jre/sassuino/sassuino-uno-dip/sassuino-uno-dip.kicad_pcb

## KiCad design sassuino-uno-dip/sassuino-uno-dip.kicad_pcb (2025-06-15)

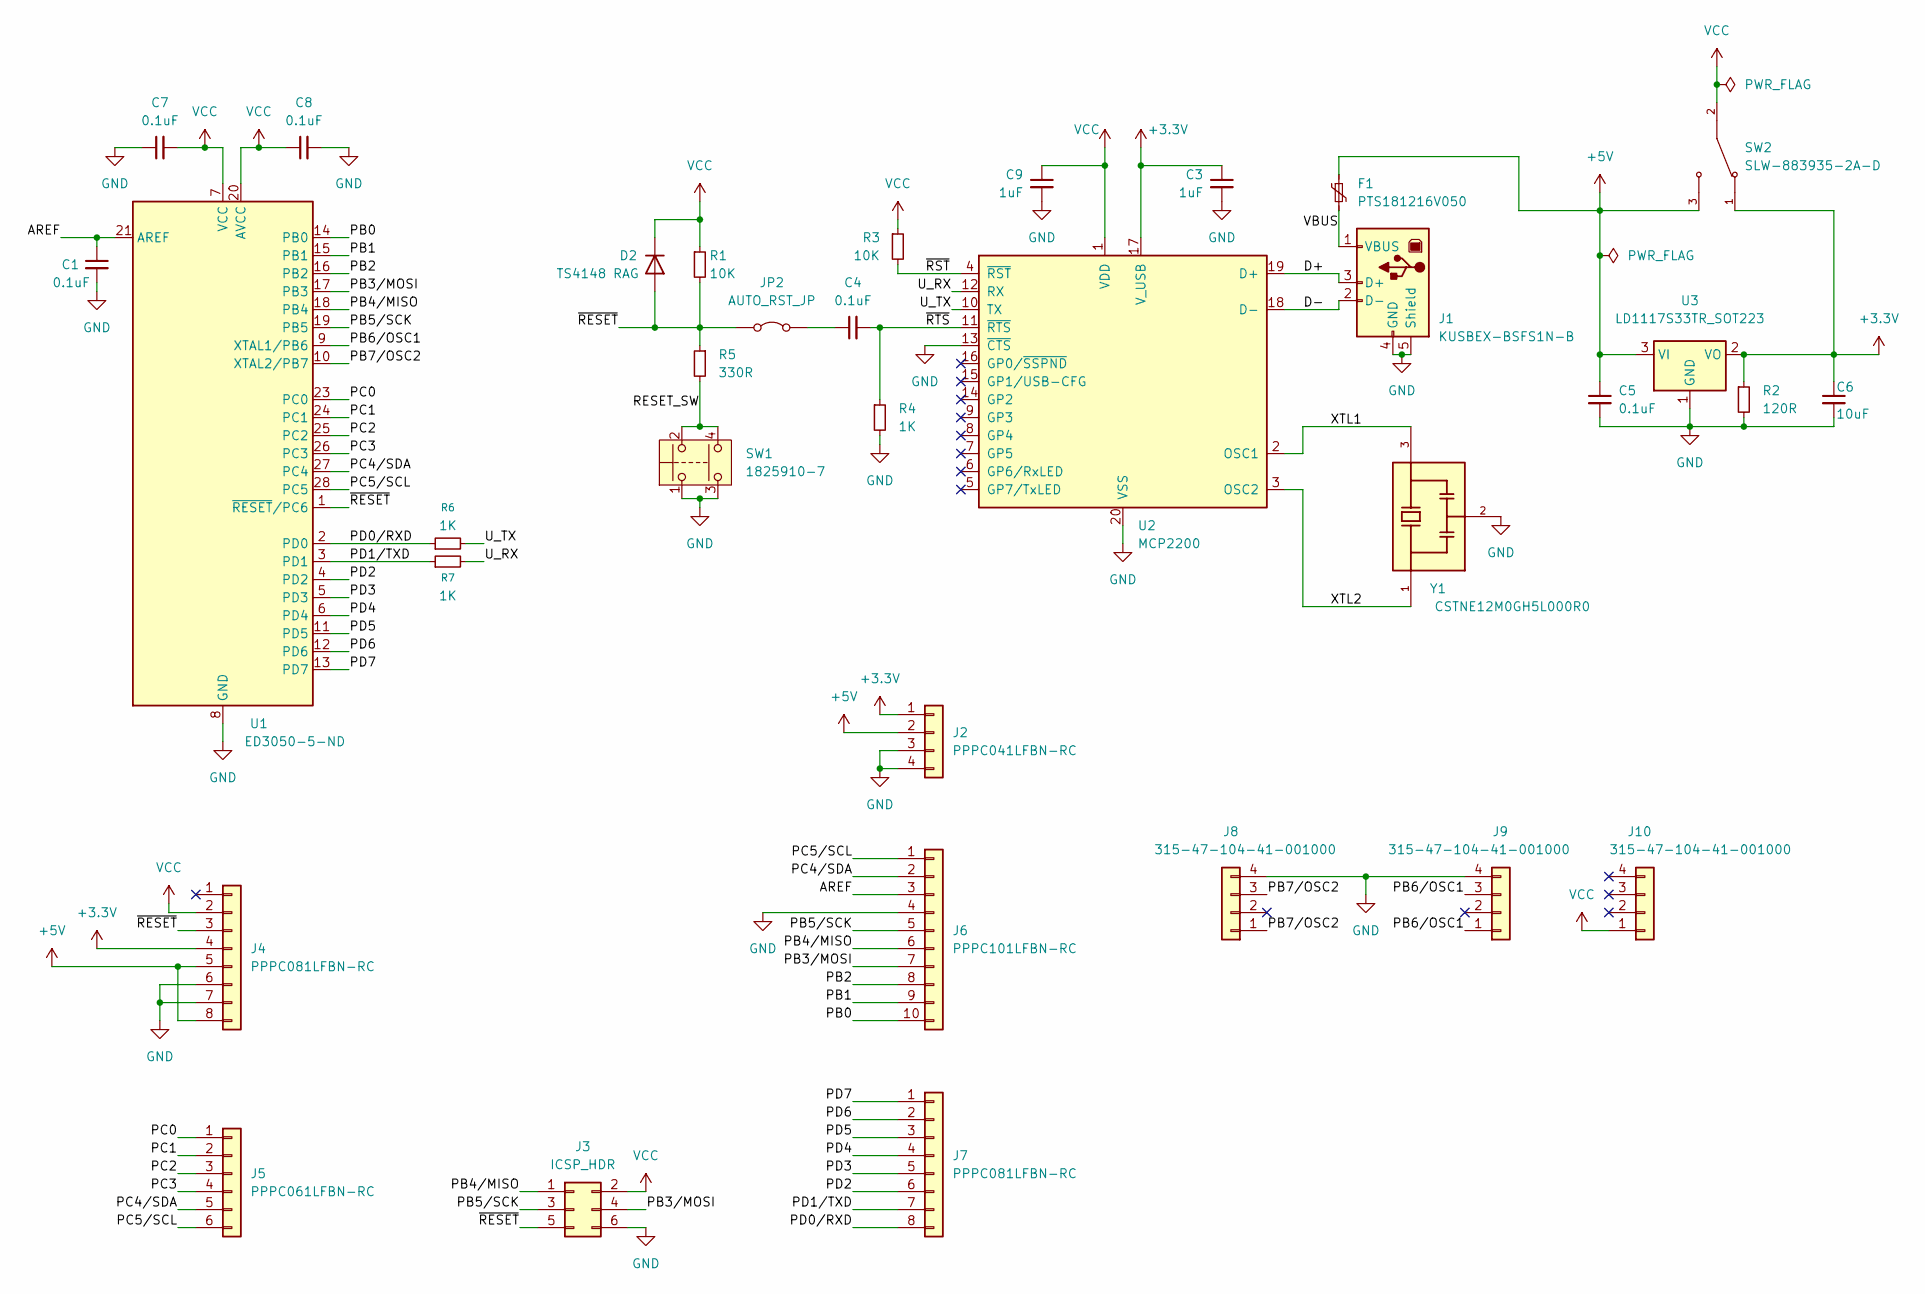
[picture p1: schematic sassuino-uno-dip.kicad_sch, Sassuino Uno DIP]

Parts:
C1, C4, C5, C7, C8: 0.1uF; C_1206_3216Metric
C3, C9: 1uF; C_1206_3216Metric
C6: 10uF; C_1206_3216Metric
D2: TS4148 RAG; D_1206_3216Metric
F1: PTS181216V050; Fuse_1812_4532Metric
J1: KUSBEX-BSFS1N-B; USB_B_Lumberg_2411_02_Horizontal
J2: PPPC041LFBN-RC; PinSocket_1x04_P2.54mm_Vertical
J3: ICSP_HDR; PinHeader_2x03_P2.54mm_Vertical
J4, J7: PPPC081LFBN-RC; PinSocket_1x08_P2.54mm_Vertical
J5: PPPC061LFBN-RC; PinSocket_1x06_P2.54mm_Vertical
J6: PPPC101LFBN-RC; PinSocket_1x10_P2.54mm_Vertical
J8, J9, J10: 315-47-104-41-001000; PinSocket_1x04_P2.54mm_Vertical_LowProfile
JP2: AUTO_RST_JP; PinHeader_1x02_P2.54mm_Vertical
R1, R3: 10K; R_1206_3216Metric
R2: 120R; R_1206_3216Metric
R4, R6, R7: 1K; R_1206_3216Metric
R5: 330R; R_1206_3216Metric
SW1: 1825910-7; SW4_1825910-B_TEC
SW2: SLW-883935-2A-D; SW_SLW-883935-2A-D; PARTREV 1.01
U1: ED3050-5-ND; DIP-28_W7.62mm_Socket_LongPads
U2: MCP2200; SOIC-20W_7.5x12.8mm_P1.27mm
U3: LD1117S33TR_SOT223; SOT-223-3_TabPin2
Y1: CSTNE12M0GH5L000R0; OSC_CSTNE12M0GH5L000R0; PARTREV JGC42-8858A

Connections:
+3.3V: C3.1, C6.1, J2.1, J4.4, R2.1, SW2.1, U2.17 (V_USB), U3.2 (VO)
+5V: C5.1, F1.1, J2.2, J4.5, J4.8, SW2.3, U3.3 (VI)
/AREF: C1.1, J6.3, U1.21 (AREF)
/D+: J1.3 (D+), U2.19 (D+)
/D-: J1.2 (D-), U2.18 (D-)
/PB0: J6.10, U1.14 (PB0)
/PB1: J6.9, U1.15 (PB1)
/PB2: J6.8, U1.16 (PB2)
/PB3/MOSI: J3.4, J6.7, U1.17 (PB3)
/PB4/MISO: J3.1, J6.6, U1.18 (PB4)
/PB5/SCK: J3.3, J6.5, U1.19 (PB5)
/PB6/OSC1: J9.1, J9.3, U1.9 (XTAL1/PB6)
/PB7/OSC2: J8.1, J8.3, U1.10 (XTAL2/PB7)
/PC0: J5.1, U1.23 (PC0)
/PC1: J5.2, U1.24 (PC1)
/PC2: J5.3, U1.25 (PC2)
/PC3: J5.4, U1.26 (PC3)
/PC4/SDA: J5.5, J6.2, U1.27 (PC4)
/PC5/SCL: J5.6, J6.1, U1.28 (PC5)
/PD0/RXD: J7.8, R6.1, U1.2 (PD0)
/PD1/TXD: J7.7, R7.1, U1.3 (PD1)
/PD2: J7.6, U1.4 (PD2)
/PD3: J7.5, U1.5 (PD3)
/PD4: J7.4, U1.6 (PD4)
/PD5: J7.3, U1.11 (PD5)
/PD6: J7.2, U1.12 (PD6)
/PD7: J7.1, U1.13 (PD7)
/RESET_SW: R5.2, SW1.2, SW1.4
/U_RX: R7.2, U2.12 (RX)
/U_TX: R6.2, U2.10 (TX)
/VBUS: F1.2, J1.1 (VBUS)
/XTL1: U2.2 (OSC1), Y1.3
/XTL2: U2.3 (OSC2), Y1.1
/~RESET: D2.2 (A), J3.5, J4.3, JP2.1 (A), R1.2, R5.1, U1.1 (~RESET/PC6)
/~RST: R3.2, U2.4 (~RST)
/~RTS: C4.2, R4.1, U2.11 (~RTS)
GND: C1.2, C3.2, C5.2, C6.2, C7.1, C8.2, C9.2, J1.4 (GND), J1.5 (Shield), J2.3, J2.4, J3.6, J4.6, J4.7, J6.4, J8.4, J9.4, R2.2, R4.2, SW1.1, SW1.3, U1.8 (GND), U1.22 (GND), U2.13 (~CTS), U2.20 (VSS), U3.1 (GND), Y1.2
unnamed: C4.1, JP2.2 (B)
VCC: C7.2, C8.1, C9.1, D2.1 (K), J3.2, J4.2, J10.1, R1.1, R3.1, SW2.2, U1.7 (VCC), U1.20 (AVCC), U2.1 (VDD)

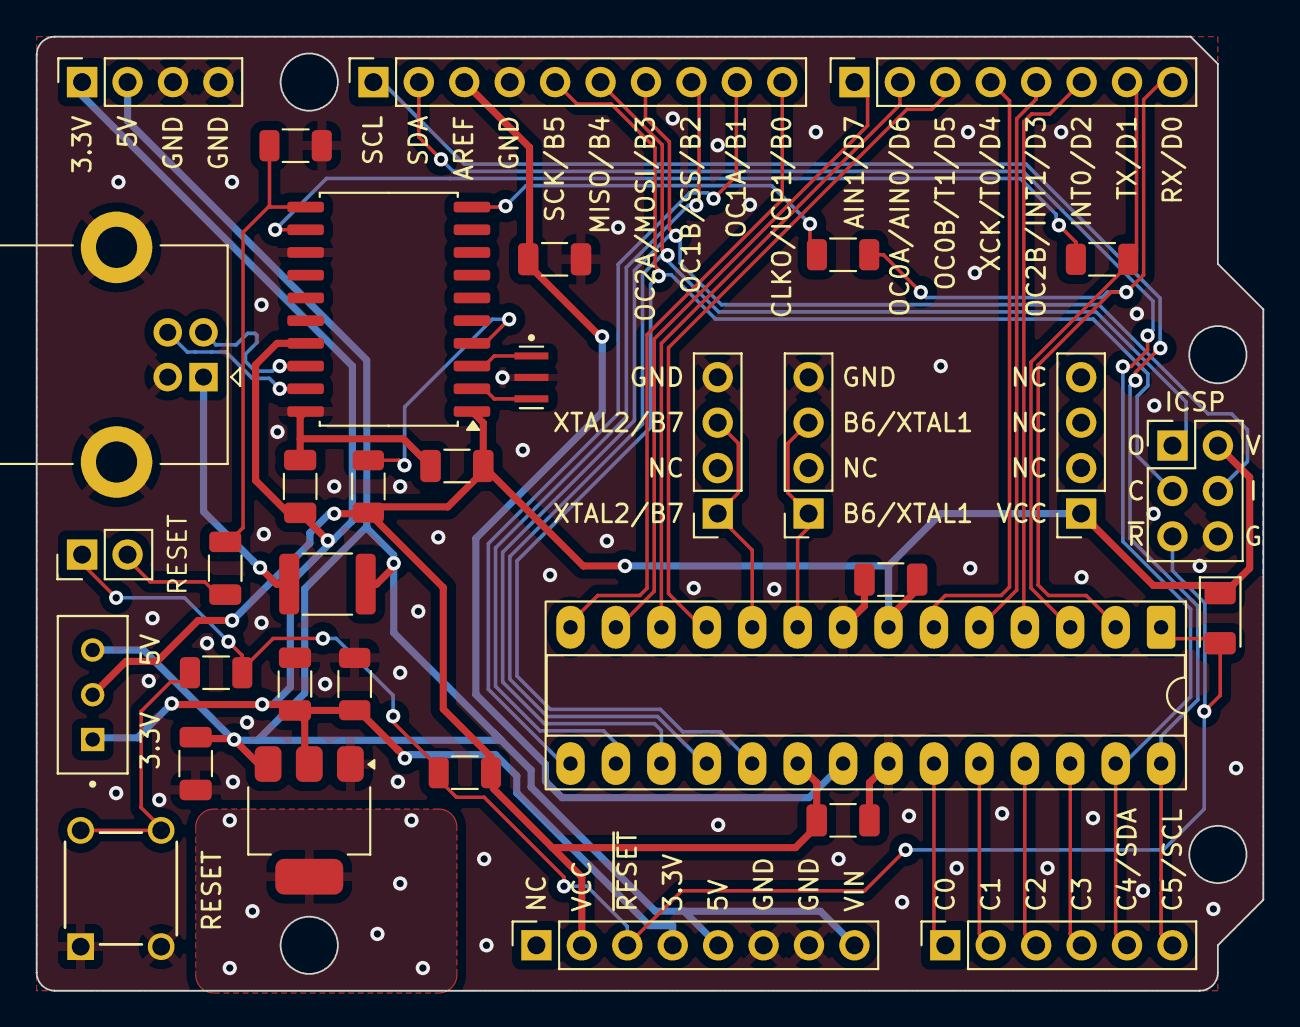
[picture p2: board sassuino-uno-dip.kicad_pcb from above]

Board: 2 copper layers, 68.6 x 53.3 mm, 34 parts (0 on the bottom side), 39 nets.
