jre/sassuino/(commit log)

2025-06-02 Import Sassuino Uno DIP project
    [CSTNE12M0GH5L000R0.step, lumberg_2411_02.stp, sassuino-uno-dip.kicad_pcb, sassuino-uno-dip.kicad_sch]
2025-06-02 Ignore the kicad backup files.
2025-06-02 Move symbol/footprint/3d libraries under lib directory
    [sassuino-uno-dip.kicad_pcb]
2025-06-02 Add the actual footprint/model of the pushbutton switch I'm using.
    [sassuino-uno-dip.kicad_pcb, sassuino-uno-dip.kicad_sch]
2025-06-02 Add a clamp diode to the reset circuit.
    [sassuino-uno-dip.kicad_pcb, sassuino-uno-dip.kicad_sch]
2025-06-02 Rotate oscillator 3d model correctly.
    [sassuino-uno-dip.kicad_pcb]
2025-06-02 Add missing PWR_FLAG so the schematic passes the ERC again.
    [sassuino-uno-dip.kicad_sch]
2025-06-03 Move decoupling capacitors closer to the IC pins.
    Also connect the caps' ground pad directly to the IC ground pin,
    rather than to the ground plane.
    [sassuino-uno-dip.kicad_pcb]
2025-06-03 Move RESET# protection diode next to the MCU input pin.
    [sassuino-uno-dip.kicad_pcb]
2025-06-03 Improve the reset circuit.
    Add a 330R between the pushbutton reset switch and the capacitor, as
    per the AVR hardware design doc.
    Pull down the RTS# side of the capacitor with a 1K like in the Arduino
    schematic.
    [sassuino-uno-dip.kicad_pcb, sassuino-uno-dip.kicad_sch]
2025-06-03 Connect the Vin header pin.
    [sassuino-uno-dip.kicad_pcb, sassuino-uno-dip.kicad_sch]
2025-06-03 Ignore generated BOM files
2025-06-05 Update to kicad 9
    Various minor tweaks to PCB traces to satisfy the DRC.
    Use a generic 3d model for the slide switch.
    [sassuino-uno-dip.kicad_pcb, sassuino-uno-dip.kicad_sch]
2025-06-05 Minor tweaks to PCB traces and copper fill zones.
    [sassuino-uno-dip.kicad_pcb, sassuino-uno-dip.kicad_sch]
2025-06-06 Equalize length of differential usb traces.
    [sassuino-uno-dip.kicad_pcb]
2025-06-06 Add a polyfuse on VBUS.
    Also ditch the VBUS decoupling cap, I don't recall why I added it.
    [sassuino-uno-dip.kicad_pcb, sassuino-uno-dip.kicad_sch]
2025-06-06 Remove the diode between the two LDOs, I don't remember why it was there.
    [sassuino-uno-dip.kicad_pcb, sassuino-uno-dip.kicad_sch]
2025-06-07 Replace crystal header 3d model with the part I'll likely be using.
    [sassuino-uno-dip.kicad_pcb, sassuino-uno-dip.kicad_sch]
2025-06-07 Various cosmetic tweaks.
    Switch a few 3d models to the part I'm using.
    Update the value of a few symbols to the part number.
    Tweak a few traces and silkscreen bits.
    [sassuino-uno-dip.kicad_pcb, sassuino-uno-dip.kicad_sch]
2025-06-07 Clean up power traces a bit.
    [sassuino-uno-dip.kicad_pcb]
2025-06-07 Move the auto-reset enable header out of the way of shields.
    [sassuino-uno-dip.kicad_pcb]
2025-06-07 Add fill out part numbers in schematic
    [sassuino-uno-dip.kicad_sch]
2025-06-08 Add a couple resistors to protect the MCP2200's TX/RX pins from the MCU.
    [sassuino-uno-dip.kicad_pcb, sassuino-uno-dip.kicad_sch]
2025-06-09 Bump dates and configure fabrication output directory.
    [sassuino-uno-dip.kicad_pcb, sassuino-uno-dip.kicad_sch]
2025-06-15 Adjust position of oscillator headers and nearby cap.
    This is to allow a crystal with 200 mil leads to be soldered, while
    leaving the headers unpopulated.
    There might not quite be enough room to solder a 14-dip oscillator in
    place of the other two headers, but I don't think I would find that
    useful.
    Also tweak a few vias to avoid intersecting with the silkscreen.
    [sassuino-uno-dip.kicad_pcb]
